jaydenguo832/ELEC391_2DOFLASER_PCB/(list of files, drawings)

Other design files:
BarrelNBattery.SchDoc
DecoderCircuit_M1.SchDoc
DecoderCircuit_M2.SchDoc
MainPCB.PcbDoc
MainPCB.SchDoc
MotorLaserPCB.PrjPcb
