jaydenguo832/ELEC391_2DOFLASER_PCB/(commit log)

2024-03-20 first comment of new decoder pcb design
    [BarrelNBattery.SchDoc, DecoderCircuit_M1.SchDoc, DecoderCircuit_M2.SchDoc, MainPCB.PcbDoc, MainPCB.SchDoc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]
2024-03-20 finalized version for submission
    [MainPCB.GBL, MainPCB.GBO, MainPCB.GBP, MainPCB.GBS, MainPCB.GKO, MainPCB.GM1, MainPCB.GTL, MainPCB.GTO]
2024-03-25 mar25th update
    [MainPCB.SchDoc]
